wangyanzu/vfd-desktop-clock/hardware/enclosure/preview.png

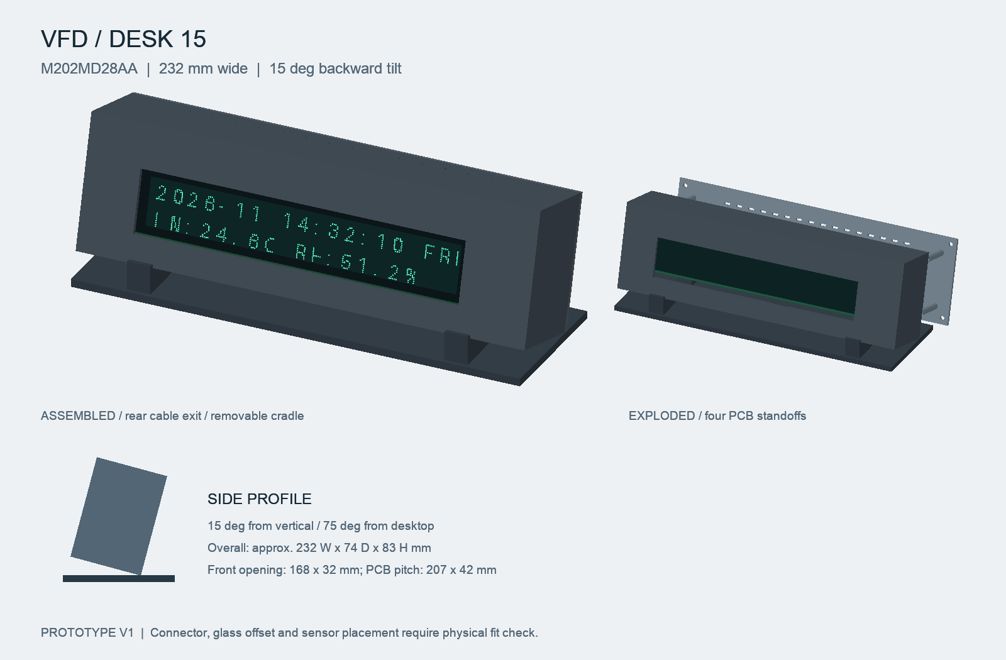
hardware/enclosure/preview.png
