wangyanzu/vfd-desktop-clock/hardware/enclosure/stand.stl

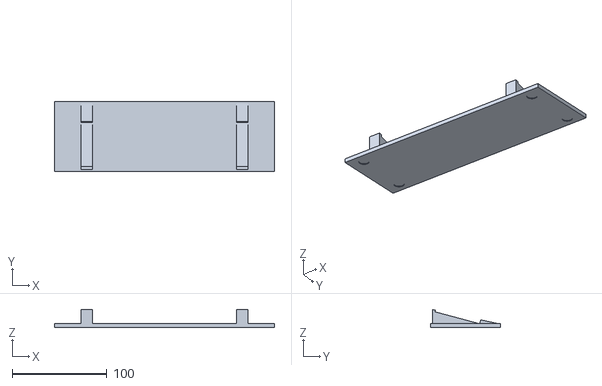
[picture p2: CAD file, 2026-11-06]
hardware/enclosure/stand.stl
232.0 x 74.0 x 19.0
