wangyanzu/vfd-desktop-clock/hardware/enclosure/lid.stl

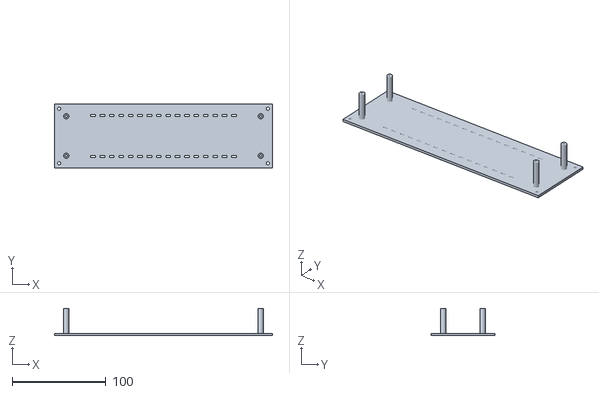
[picture p3: CAD file, 2026-11-06]
hardware/enclosure/lid.stl
232.0 x 68.0 x 29.1
