wangyanzu/vfd-desktop-clock/hardware/enclosure/body.stl

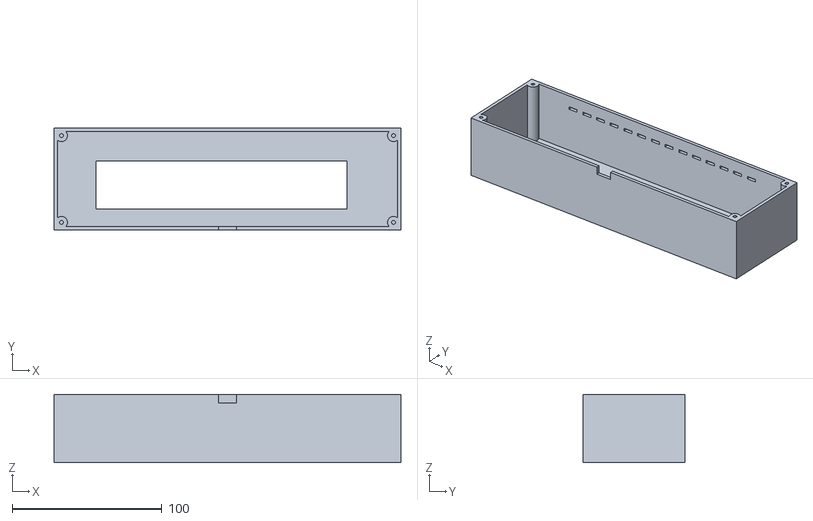
[picture p4: CAD file, 2026-11-06]
hardware/enclosure/body.stl
232.0 x 68.0 x 45.6
