wangyanzu/vfd-desktop-clock/include/clock/esp8266_tls.h

#pragma once
#include <WiFiClientSecureBearSSL.h>
#include "clock/config.h"

namespace clockapp {
// Public CA roots from Mozilla's CA store for Seniverse and Bemfa. BearSSL
// verifies the server hostname and the chain against the current time.
inline constexpr char esp8266ServiceRoots[] PROGMEM = R"CLOCKCA(
-----BEGIN CERTIFICATE-----
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
MrY=
-----END CERTIFICATE-----
-----BEGIN CERTIFICATE-----
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
-----END CERTIFICATE-----
-----BEGIN CERTIFICATE-----
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
/q4AaOeMSQ+2b1tbFfLn
-----END CERTIFICATE-----
)CLOCKCA";
inline const BearSSL::X509List& serviceTrustAnchors() {
  static const BearSSL::X509List anchors(esp8266ServiceRoots);
  return anchors;
}
}
