wangyanzu/vfd-desktop-clock/m202md28aa.h

// 光标向左移动一个字体
const char VFD_Back_Space[5]={0x08,0x0,0x0,0x0,0x0};
// 光标向右移动一个字体
const char VFD_Horizontal_Tab[5]={0x09,0x0,0x0,0x0,0x0};
// 光标移动到下一行
const char VFD_Line_Feed[5]={0x0A,0x0,0x0,0x0,0x0};
// 光标移回起始位置(第一排的最左边)
const char VFD_Home_Position[5]={0x0B,0x0,0x0,0x0,0x0};
// 显示清除，光标移回起始位置(第一排的最左边)
const char VFD_Display_Clear[5]={0x0C,0x0,0x0,0x0,0x0};
// 光标移到当下这列的最左边
const char VFD_Carriage_Return[5]={0x0D,0x0,0x0,0x0,0x0};
// 目前的行会被清除，而且光标会移动至目前行的最左边
const char VFD_Line_Clear[5]={0x18,0x0,0x0,0x0,0x0};
// 显示模式设定成覆写型式
const char VFD_Over_write_mode[5]={0x1F,0x01,0x0,0x0,0x0};
// 显示模式设定成垂直滚动条模式
const char VFD_Vertical_scroll_mode[5]={0x1F,0x02,0x0,0x0,0x0};
// 显示模式设定成水平滚动条模式
const char VFD_Horizontal_scroll_mode[5]={0x1F,0x03,0x0,0x0,0x0};
// 游标移置上一行
const char VFD_Upper_line[5]={0x1F,0x0A,0x0,0x0,0x0};
// 光标移到目前行的最右端
const char VFD_Right_end[5]={0x1F,0x0D,0x0,0x0,0x0};
// 光标移到特定的 X, Y 位置
// x 0x01 - 0x14
// y 0x01 - 0x2
const char VFD_Cursor_set[5]={0x1F,0x24,0x0,0x0,0x0};
// 光标移到结束位置
const char VFD_End_position[5]={0x1F,0x42,0x0,0x0,0x0};
// 设定光标显示为开启/关闭.阻断光标的闪烁时间依据时间设定在闪烁屏幕指令
const char VFD_Cursor_display[5]={0x1F,0x43,0x0,0x0,0x0};
// 屏幕闪烁控制
// 编码：1Fh 45h n
// n：闪烁显示时间
// 定义区域： n = 0 (00h) 取消闪烁屏幕
// n = 1 (01h) - 255 (FFh) 屏幕闪烁显示
const char VFD_Blink_Screen[5]={0x1F,0x45,0x0,0x0,0x0};
// 设定显示亮度程度
// 定义的区域：n：1 (01h) - 4 (04h)
const char VFD_Brightness_level_setting_25[5]={0x1F,0x58,0x0,0x0,0x1};
const char VFD_Brightness_level_setting_50[5]={0x1F,0x58,0x0,0x0,0x2};
const char VFD_Brightness_level_setting_75[5]={0x1F,0x58,0x0,0x0,0x3};
const char VFD_Brightness_level_setting_100[5]={0x1F,0x58,0x0,0x0,0x4};
// 字体显示明暗的反向设定开启/关闭
// 编码：1Fh 72h n
// n：反向显示设定
// 定义区域：
// n = 0 (00h)：反向的显示关闭
// n = 1 (01h)：反向的显示开启
const char VFD_Reverse_display[5]={0x1F,0x72,0x0,0x0,0x0};
// 显示电源开启/关闭
// 编码：1Fh 28h 61h 40h n
// n： 显示电源设定
// 定义区域：
// n = 0 (00h)： 显示电源关闭 (电源省电模式)
// n = 1 (01h)： 显示电源开启
const char VFD_Display_Power[5]={0x1F,0x28,0x61,0x40,0x0};
// set chinese character
const char VFD_2_byte_character_Chinese[5]={0x1F,0x28,0x67,0x02,0x01};
const char VFD_2_byte_character_type_Chinese[5]={0x1F,0x28,0x67,0x03,0x02};
// set korea character
const char VFD_2_byte_character_type_Korea[5]={0x1F,0x28,0x67,0x03,0x01};
// Initialize display
const char VFD_Initialize_display[5]={0x1B,0x40,0x00,0x00,0x00};
