wangyanzu/vfd-desktop-clock/(commit log)

2026-10-21 feat(时钟): 实现模块化固件、网页管理与消息轮播
    实现时钟校时、AHT10 采样、VFD 动画与睡眠唤醒、本地配网、MQTT 消息确认及内容轮播管理。
    包含主机测试、网页交互测试和离线动画预览；保留脱敏参考代码。
    AI-Coding: true
    AI-Agent: Codex
    AI-Model: GPT-6
2026-10-25 Improve sensor recovery, weather integration and clock display
2026-10-25 Fix MQTT TLS recursion and expose weather API errors
    [main.cpp, mqtt_service.cpp, portal.cpp, portal.h, weather_response.h, weather_response_check.cpp, weather_service.cpp, weather_service.h]
2026-10-25 Add button message confirmation, playback expiry and configurable sleep
2026-11-06 feat: unify clock onboarding and add enclosure assets
    [body.stl, enclosure.scad, lid.stl, stand.stl]
2026-11-11 feat: 完成 VFD 时钟 ESP8266 适配
